SrdjanEM/LoRaWAY/3D/TO252-3L_DIO.step

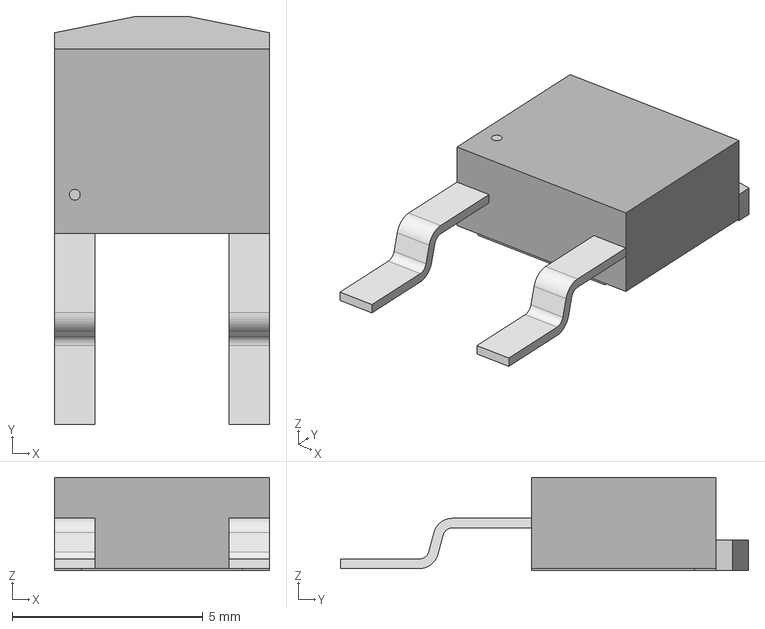
[picture p1: CAD file, 2025-12-28]
3D/TO252-3L_DIO.step
5.64 x 10.7 x 2.44 mm
