SrdjanEM/LoRaWAY/3D/U.FL-R-SMT-1.stp

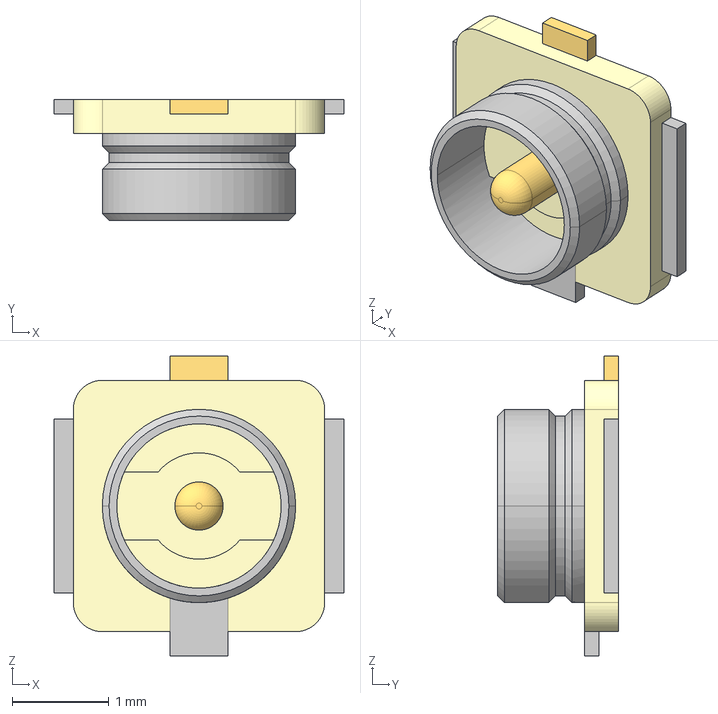
[picture p2: CAD file, 2025-12-21]
3D/U.FL-R-SMT-1.stp
3.00 x 1.25 x 3.10 mm
