SrdjanEM/LoRaWAY/3D/IC_625L3C040M00000_CTS.step

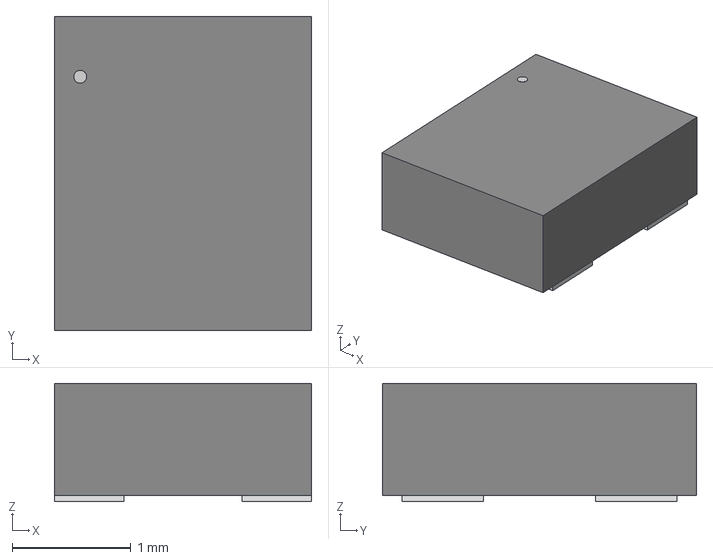
[picture p3: CAD file, 2025-12-21]
3D/IC_625L3C040M00000_CTS.step
2.16 x 2.64 x 0.993 mm
