SrdjanEM/LoRaWAY/3D/KG200ZABMD.step

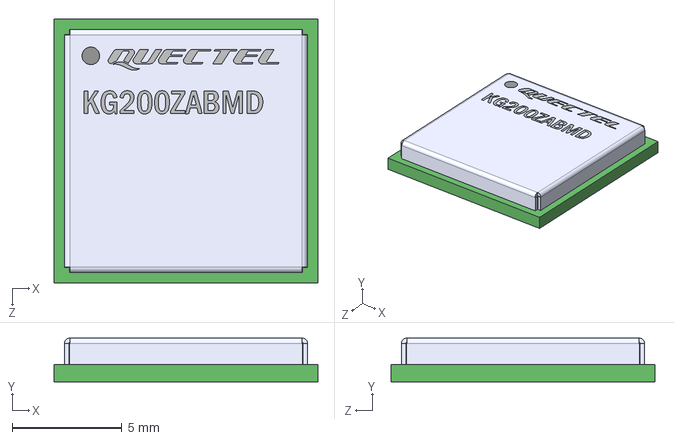
[picture p4: CAD file, 2025-12-21]
3D/KG200ZABMD.step
12.0 x 2.00 x 12.0 mm
