SrdjanEM/LoRaWAY/3D/ECS-2033-240-BN.step

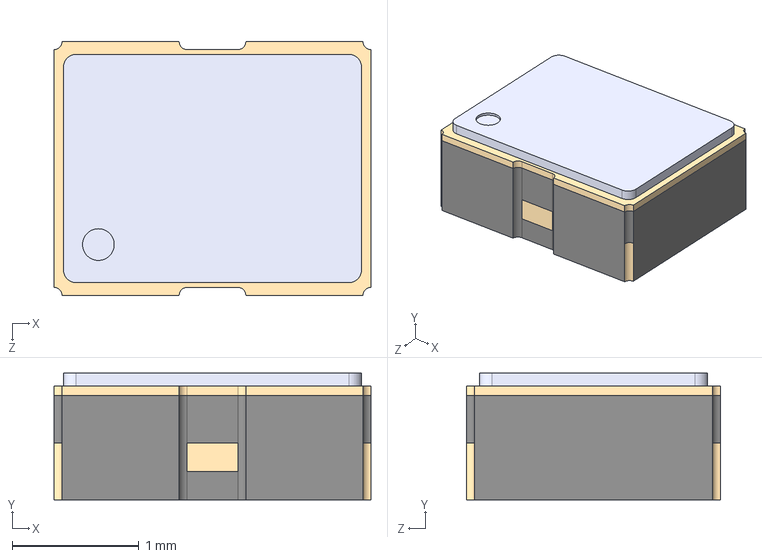
[picture p5: CAD file, 2025-12-21]
3D/ECS-2033-240-BN.step
2.50 x 1.00 x 2.00 mm
