SrdjanEM/LoRaWAY/3D/USB4105-GF-A.step

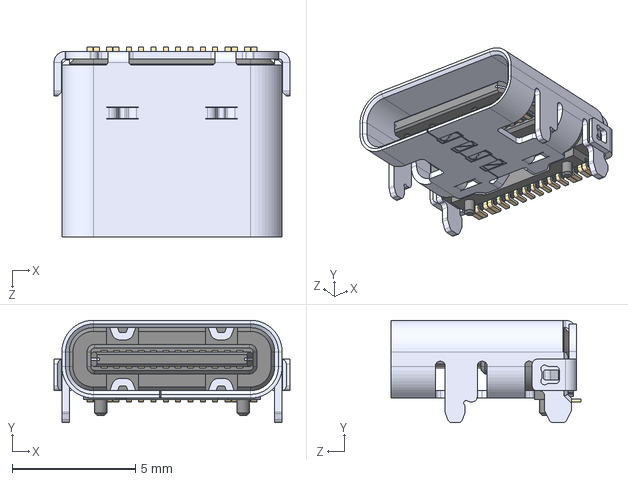
[picture p6: CAD file, 2025-12-21]
3D/USB4105-GF-A.step
9.58 x 4.16 x 7.71 mm
