SrdjanEM/LoRaWAY/3D/STM32C011F4U6TR.step

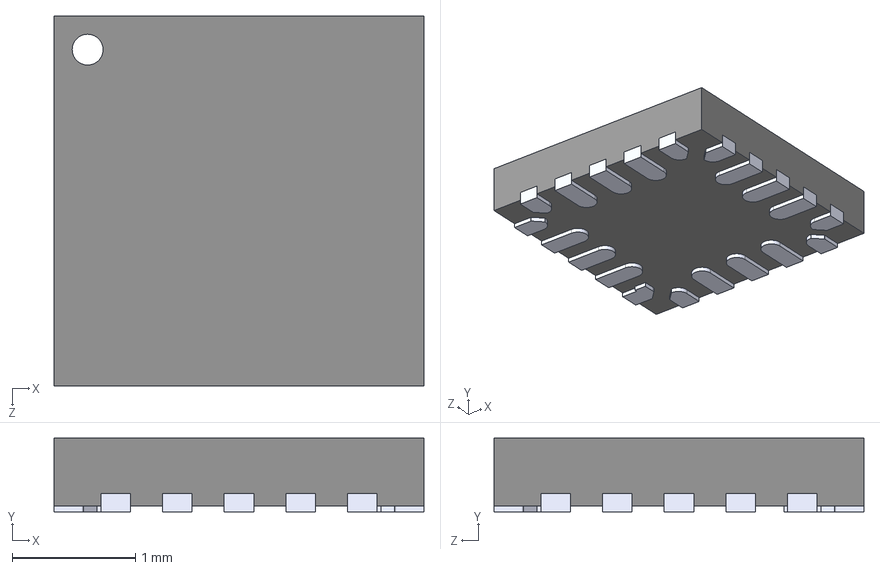
[picture p7: CAD file, 2025-12-21]
3D/STM32C011F4U6TR.step
3.00 x 0.6 x 3.00 mm
