SrdjanEM/LoRaWAY/3D/TL3365AF180QG.STEP

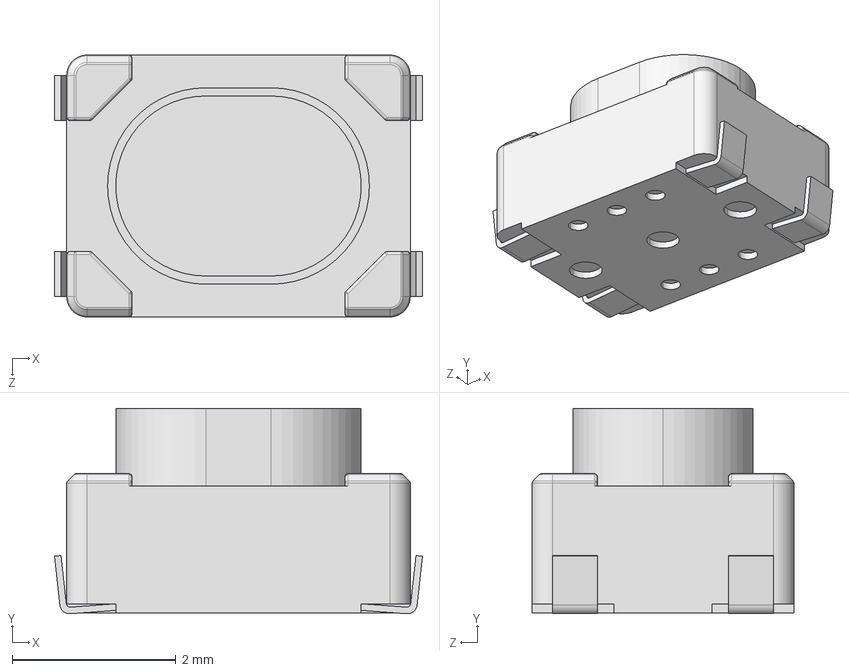
[picture p8: CAD file, 2025-12-21]
3D/TL3365AF180QG.STEP
4.50 x 2.51 x 3.20 mm
