SrdjanEM/LoRaWAY/3D/ASEK.STEP

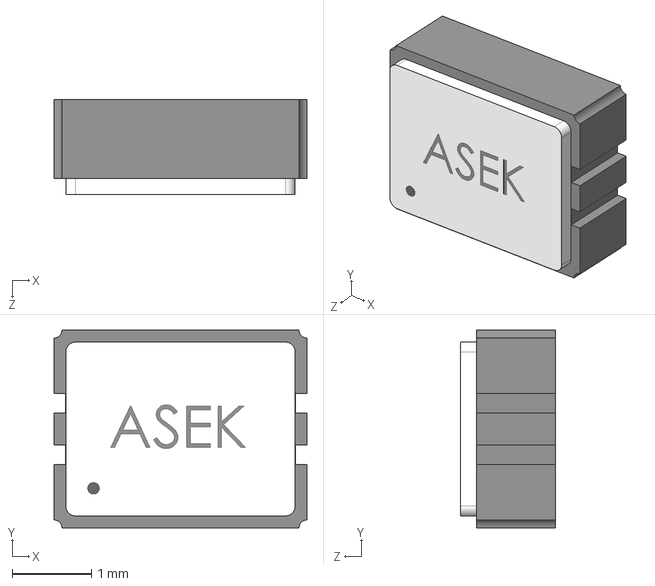
[picture p9: CAD file, 2025-12-21]
3D/ASEK.STEP
3.20 x 2.50 x 1.20 mm
