SrdjanEM/LoRaWAY/LoRaWAY.kicad_pcb

## KiCad design LoRaWAY.kicad_pcb (2026-02-09)

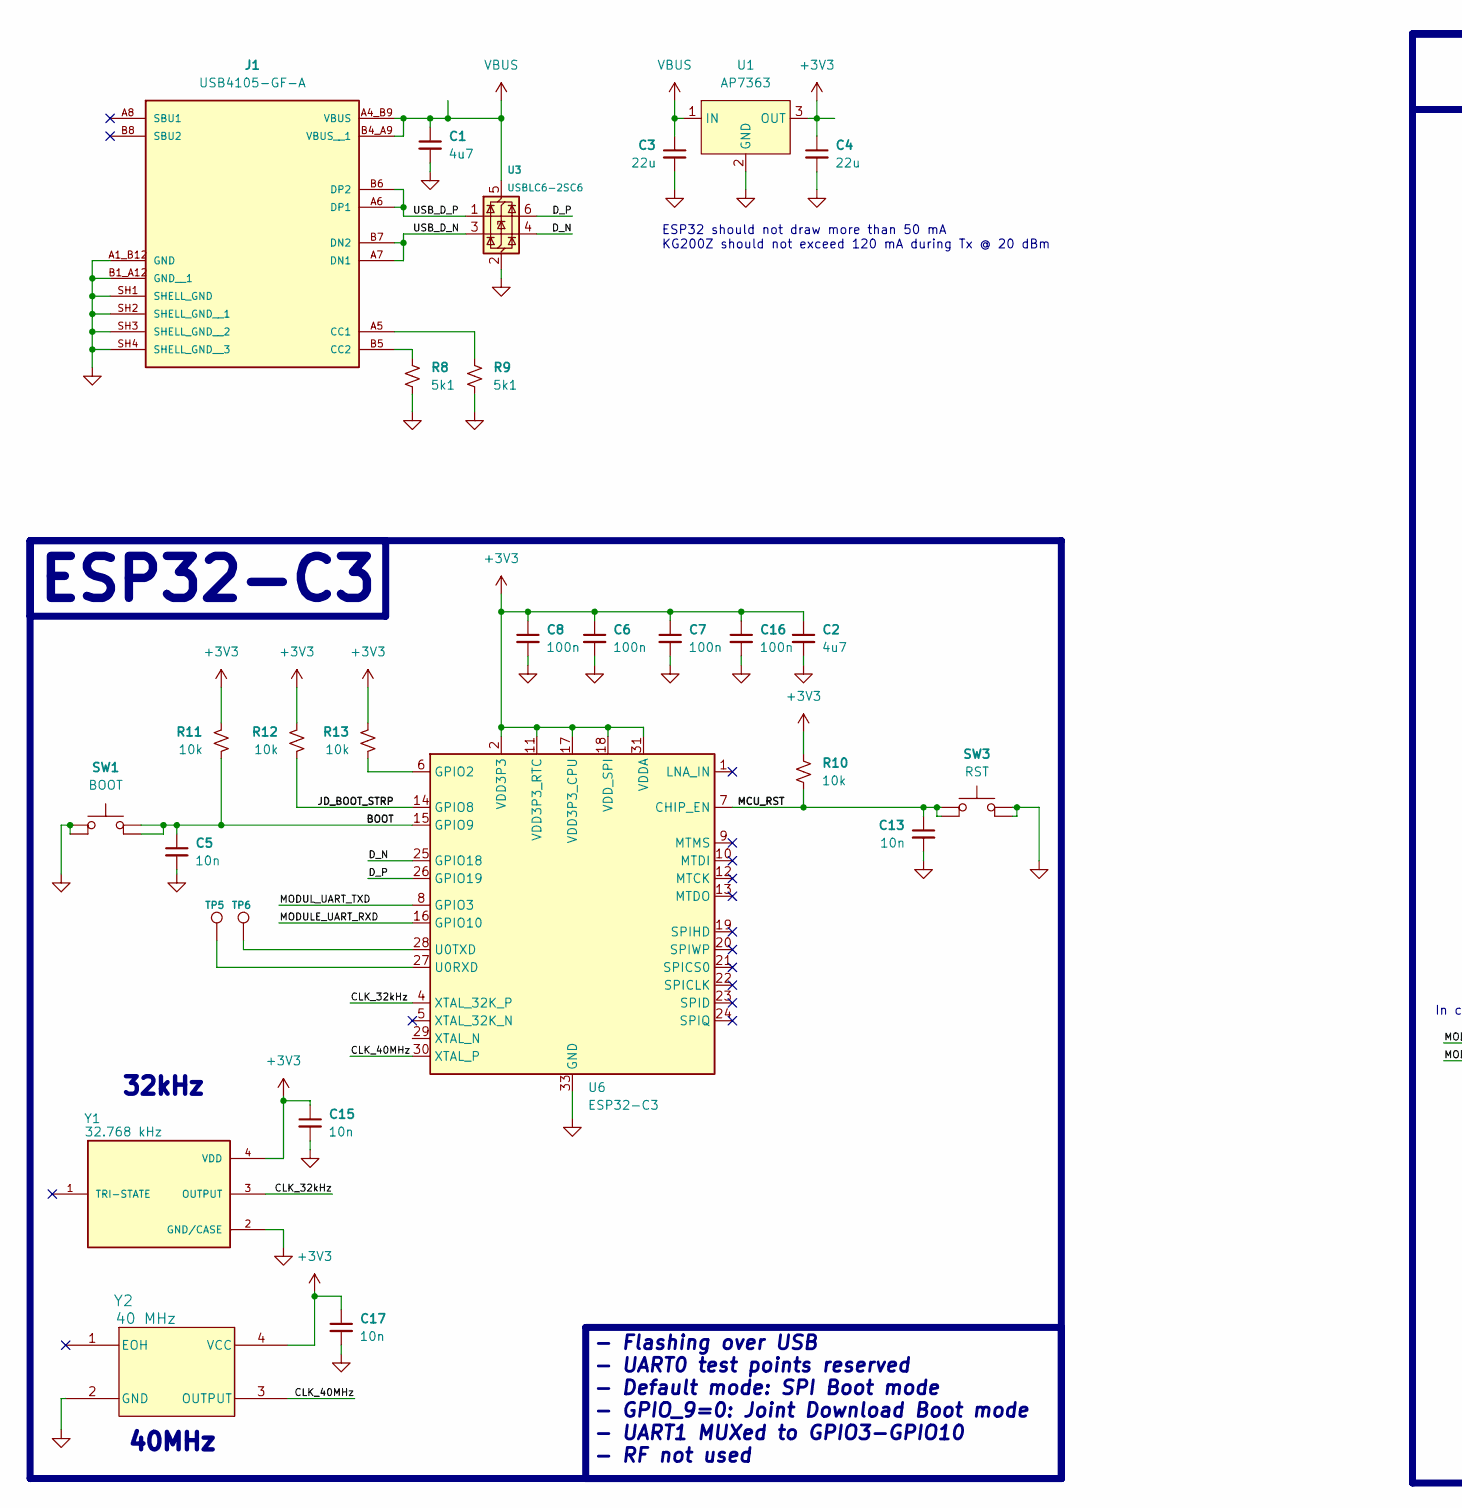
[picture p10: schematic LoRaWAY.kicad_sch, part in row 1, column 1]

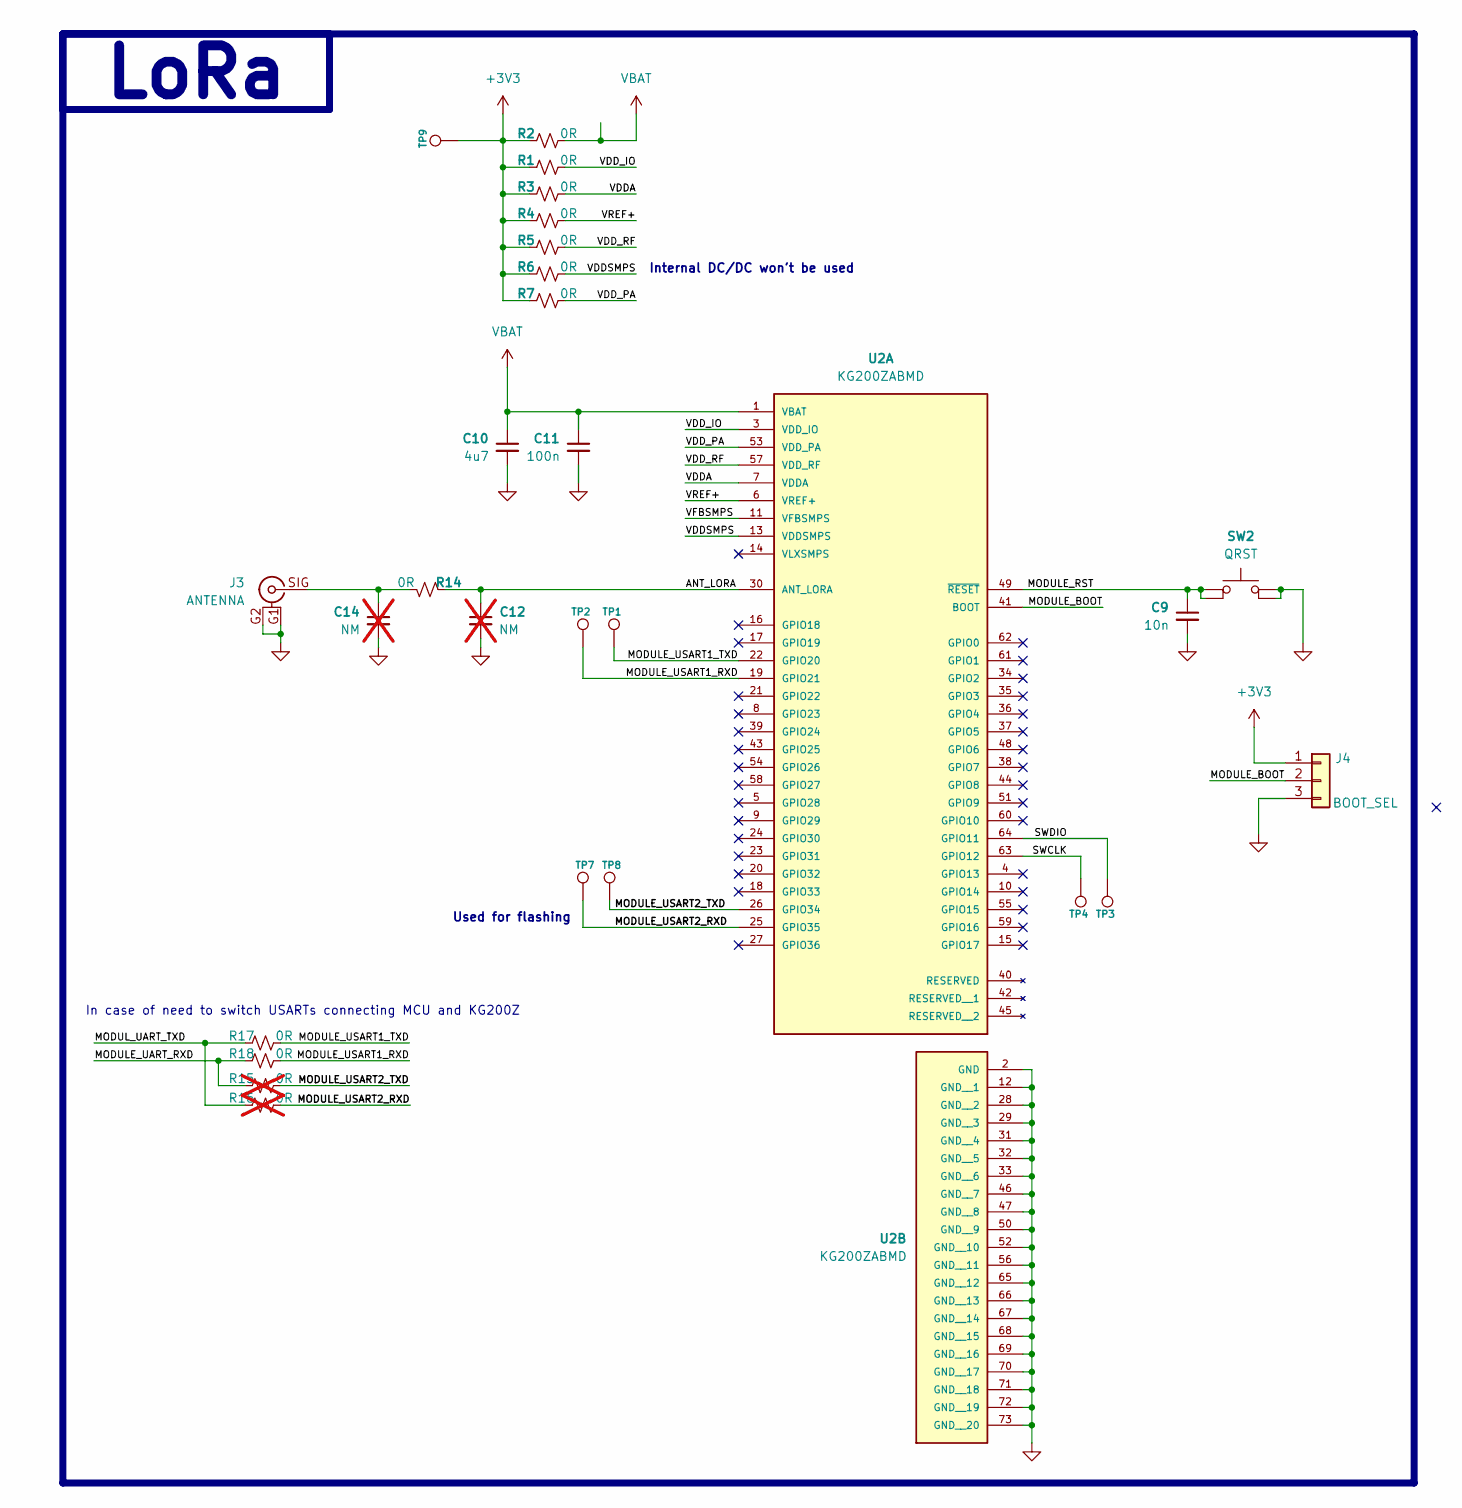
[picture p11: schematic LoRaWAY.kicad_sch, part in row 1, column 2]

Parts:
C1, C2, C10: 4u7; C_0402_1005Metric
C3, C4: 22u; C_0402_1005Metric
C5, C9, C13, C15, C17: 10n; C_0402_1005Metric
C6, C7, C8, C11, C16: 100n; C_0402_1005Metric
C12, C14: NM; C_0402_1005Metric; not fitted
J1: USB4105-GF-A; GCT_USB4105-GF-A
J3: ANTENNA; HIROSE_U.FL-R-SMT-1_80_
J4: BOOT_SEL; PinHeader_1x03_P2.54mm_Vertical
R1, R2, R3, R4, R5, R6, R7, R14, R17, R18: 0R; R_0402_1005Metric
R8, R9: 5k1; R_0402_1005Metric
R10, R11, R12, R13: 10k; R_0402_1005Metric
R15, R16: 0R; R_0402_1005Metric; not fitted
SW1: BOOT; SW4_PTS815 SJM 250 SMTR LFS_CNK
SW2: QRST; SW4_PTS815 SJM 250 SMTR LFS_CNK
SW3: RST; SW4_PTS815 SJM 250 SMTR LFS_CNK
TP1, TP2, TP3, TP4, TP5, TP6, TP7, TP8, TP9: TestPoint; TestPoint_Pad_D1.0mm
U1: AP7363; TO252-3L_DIO; MPN AP7363-33D-13
U2: KG200ZABMD; XCVR_KG200ZABMD; PARTREV 1.0
U3: USBLC6-2SC6; SOT-23-6
U6: ESP32-C3; QFN-32-1EP_5x5mm_P0.5mm_EP3.7x3.7mm
Y1: 32.768 kHz; XTAL_ASEK-32.768KHZ-L-R-T; MPN ASEK-32.768KHZ-L-R-T
Y2: 40 MHz; IC_625L3C040M00000_CTS; MPN 625L3C040M00000

Connections:
+3V3: C2.1, C4.1, C6.1, C7.1, C8.1, C15.1, C16.1, C17.1, J4.1, R1.1, R2.1, R3.1, R4.1, R5.1, R6.1, R7.1, R10.1, R11.1, R12.1, R13.1, TP9.1, U1.3 (OUT), U6.2 (VDD3P3), U6.3 (VDD3P3), U6.11 (VDD3P3_RTC), U6.17 (VDD3P3_CPU), U6.18 (VDD_SPI), U6.31 (VDDA), U6.32 (VDDA), Y1.4 (VDD), Y2.4 (VCC)
/ANT_LORA: C12.1, R14.1, U2.30 (ANT_LORA)
/BOOT: C5.1, R11.2, SW1.1, SW1.2, U6.15 (GPIO9)
/CLK_32kHz: U6.4 (XTAL_32K_P), Y1.3 (OUTPUT)
/CLK_40MHz: U6.30 (XTAL_P), Y2.3 (OUTPUT)
/D_N: U3.4 (I/O2), U6.25 (GPIO18)
/D_P: U3.6 (I/O1), U6.26 (GPIO19)
/JD_BOOT_STRP: R12.2, U6.14 (GPIO8)
/MCU_RST: C13.1, R10.2, SW3.3, SW3.4 (3), U6.7 (CHIP_EN)
/MODULE_BOOT: J4.2, U2.41 (BOOT)
/MODULE_RST: C9.1, SW2.3, SW2.4 (3), U2.49 (~RESET)
/MODULE_UART_RXD: R15.1, R18.1, U6.16 (GPIO10)
/MODULE_USART1_RXD: R18.2, TP2.1, U2.19 (GPIO21)
/MODULE_USART1_TXD: R17.2, TP1.1, U2.22 (GPIO20)
/MODULE_USART2_RXD: R16.2, TP7.1, U2.25 (GPIO35)
/MODULE_USART2_TXD: R15.2, TP8.1, U2.26 (GPIO34)
/MODUL_UART_TXD: R16.1, R17.1, U6.8 (GPIO3)
/SWCLK: TP4.1, U2.63 (GPIO12)
/SWDIO: TP3.1, U2.64 (GPIO11)
/USB_D_N: J1.A7 (DN1), J1.B7 (DN2), U3.3 (I/O2)
/USB_D_P: J1.A6 (DP1), J1.B6 (DP2), U3.1 (I/O1)
/VDDA: R3.2, U2.7 (VDDA)
/VDDSMPS: R6.2, U2.13 (VDDSMPS)
/VDD_IO: R1.2, U2.3 (VDD_IO)
/VDD_PA: R7.2, U2.53 (VDD_PA)
/VDD_RF: R5.2, U2.57 (VDD_RF)
/VFBSMPS: U2.11 (VFBSMPS)
/VREF+: R4.2, U2.6 (VREF+)
GND: C1.2, C2.2, C3.2, C4.2, C5.2, C6.2, C7.2, C8.2, C9.2, C10.2, C11.2, C12.2, C13.2, C14.2, C15.2, C16.2, C17.2, J1.A1_B12 (GND), J1.B1_A12 (GND__1), J1.SH1 (SHELL_GND), J1.SH2 (SHELL_GND__1), J1.SH3 (SHELL_GND__2), J1.SH4 (SHELL_GND__3), J3.G1 (Ext), J3.G2 (Ext), J4.3, R8.2, R9.2, SW1.3, SW1.4 (3), SW2.1, SW2.2, SW3.1, SW3.2, U1.2 (GND), U2.2 (GND), U2.12 (GND__1), U2.28 (GND__2), U2.29 (GND__3), U2.31 (GND__4), U2.32 (GND__5), U2.33 (GND__6), U2.46 (GND__7), U2.47 (GND__8), U2.50 (GND__9), U2.52 (GND__10), U2.56 (GND__11), U2.65 (GND__12), U2.66 (GND__13), U2.67 (GND__14), U2.68 (GND__15), U2.69 (GND__16), U2.70 (GND__17), U2.71 (GND__18), U2.72 (GND__19), U2.73 (GND__20), U3.2 (GND), U6.33 (GND), Y1.2 (GND/CASE), Y2.2 (GND)
unnamed: J1.A5 (CC1), R9.1
unnamed: J1.B5 (CC2), R8.1
unnamed: C14.1, J3.SIG (In), R14.2
unnamed: R13.2, U6.6 (GPIO2)
unnamed: TP5.1, U6.27 (U0RXD)
unnamed: TP6.1, U6.28 (U0TXD)
VBAT: C10.1, C11.1, R2.2, U2.1 (VBAT)
VBUS: C1.1, C3.1, J1.A4_B9 (VBUS), J1.B4_A9 (VBUS__1), U1.1 (IN), U3.5 (VBUS)

Notes on the sheet:
Internal DC/DC won't be used
ESP32 should not draw more than 50 mA KG200Z should not exceed 120 mA during Tx @ 20 dBm
In case of need to switch USARTs connecting MCU and KG200Z
40MHz
32kHz
Used for flashing
LoRa
- Flashing over USB - UART0 test points reserved - Default mode: SPI Boot mode - GPIO_9=0: Joint Download Boot mode - UART1 MUXed to GPIO3-GPIO10 - RF not used
ESP32-C3

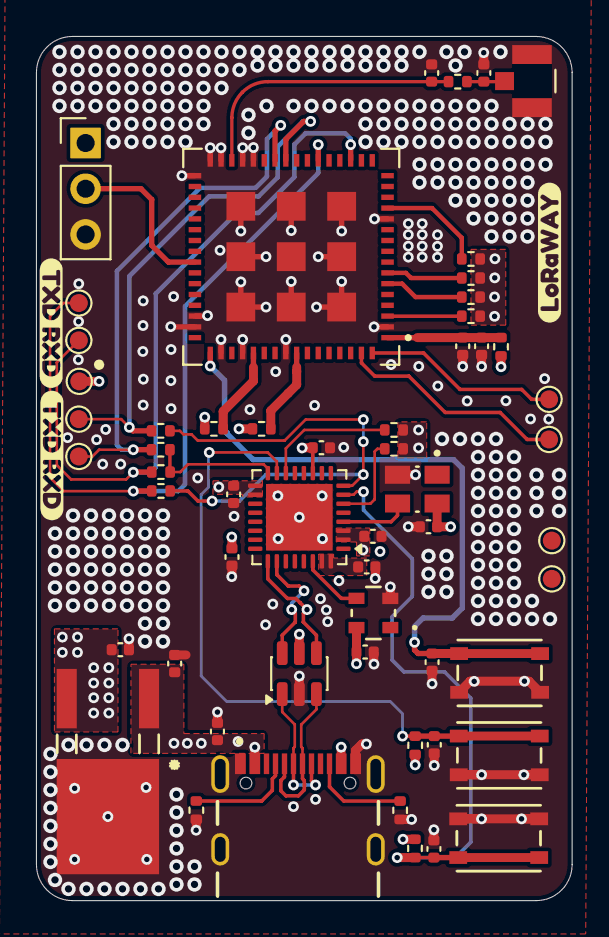
[picture p12: board LoRaWAY.kicad_pcb from above]

Board: 4 copper layers, 29.8 x 48.0 mm, 59 parts (0 on the bottom side), 36 nets.

Other parts of the board:
kibuzzard-69502FA5: G***; kibuzzard-69502FA5
kibuzzard-694845CE, kibuzzard-694845CE#2: G***; kibuzzard-694845CE
