SrdjanEM/LoRaWAY/(commit log)

2025-12-21 Review request
    [ASEK.STEP, ECS-2033-240-BN.step, IC_625L3C040M00000_CTS.step, KG200ZABMD.step, LoRaWAY.kicad_pcb, LoRaWAY.kicad_sch, STM32C011F4U6TR.step, TL3365AF180QG.STEP]
2025-12-28 Pre-release v1.0
    [LoRaWAY.kicad_pcb, LoRaWAY.kicad_sch, TO252-3L_DIO.step]
2026-02-09 Final design
    [LoRaWAY.csv, LoRaWAY.kicad_pcb, LoRaWAY.kicad_sch]
